Zain-Naqvi-tech/ARM-baremetal-CAN-IDS/README.md

# ARM-BareMetal-CAN-IDS

**A multi-ECU automotive CAN network featuring a custom firmware-level Intrusion Detection System (IDS).**

## Project Overview
This project implements a secure, multi-node automotive controller area network (CAN) entirely on a single ARM Cortex-M4 microcontroller (MSP432E401Y) using bare-metal C. 

By leveraging the dual built-in CAN controllers (CAN0 and CAN1) routed through external physical transceivers, this system creates two independent hardware nodes operating on a shared physical bus:
* **Node 1 (Engine ECU):** Broadcasts realistic automotive telemetry (RPM, throttle, speed, and temperature) at standard vehicular message rates.
* **Node 2 (Body Control Module):** Actively listens, processes, and responds to the network traffic.

## At a Glance

Five anomaly detectors, an on-demand fault-injection framework driven over UART, and a live Python dashboard.

| Detection | What it catches | Method | Verified on hardware |
|---|---|---|---|
| **Over-range** | A signal past its physical limit (RPM > 6000) | Per-frame value check in the RX interrupt | ✅ RPM forced to 6500, flagged every frame |
| **Too-fast** | A message arriving faster than its schedule (replay / injection) | Inter-arrival timing vs. expected period | ✅ Extra throttle frame every 1600 ms, flagged |
| **Missing** | A message that stops arriving (silenced / dropped node) | Deadline watchdog scanned in the main loop | ✅ Speed silenced 2 s, flagged on the deadline, recovers on resume |
| **Unknown ID** | A frame from an ID outside the known network (rogue ECU) | Hardware catch-all message object + match priority | ✅ Rogue 0x500 flagged, known IDs untouched |
| **Spike (rate-of-change)** | A value that stays in range but jumps faster than physically possible (in-range spoofing) | Frame-to-frame delta vs. a per-signal limit | ✅ Coolant forced 30 → 60 C, flagged once on the jump |

**Interactive:** every attack is triggerable live from the host with a single keypress over UART, and the dashboard shows each signal decoded into real units with color-coded status. Detection spans three axes: **value** (is it possible?), **timing** (too fast, or gone?), and **identity** (does this ID belong?), plus a rate-of-change rule for spoofing that stays within legal bounds.

Demos:

[Python Dashboard](https://youtu.be/XWLsz7M9KcM) 

[Realterm Ouput](https://youtu.be/OpzYNLC9uAE)

Full implementation, the debugging stories, and the design decisions behind each detector are in the milestones below. Performance Metrics are included at the end

## Phase 1: Hardware Setup & Bare-Metal Initialization
* **External Hardware:** Utilized SN65HVD230 CAN transceivers for physical communication. The modules include built-in 120Ω termination resistors across the CANH and CANL headers.
* **MCU Configuration:** Located and mapped the specific registers and GPIO pins responsible for CAN communication on the Cortex-M4.
* **Bit Timing:** Researched CAN bit timing architecture and calculated the appropriate Baud Rate Prescaler (BRP) using the standard bit rate formula to establish a stable connection.

Transceiver Used:
WhatsApp Image 2026-05-28 at 00 55 18

### Wiring Setup
The physical bus uses a twisted-pair configuration to resolve electromagnetic interference (EMI) and maintain signal integrity.



WhatsApp Image 2026-05-28 at 00 55 05

**The Physical Bus (Backbone)**
* `CANH` on Transceiver 1 <---> `CANH` on Transceiver 2
* `CANL` on Transceiver 1 <---> `CANL` on Transceiver 2
(These two wires are twisted together between the nodes).

**Node 1 (CAN0 - Engine ECU)**
* `VCC`  -> MCU 3.3V
* `GND`  -> MCU Common GND
* `TXD`  -> MCU Pin PA1 (CAN0TX)
* `RXD`  -> MCU Pin PA0 (CAN0RX)

**Node 2 (CAN1 - Body Control Module)**
* `VCC`  -> MCU 3.3V
* `GND`  -> MCU Common GND
* `TXD`  -> MCU Pin PB1 (CAN1TX)
* `RXD`  -> MCU Pin PB0 (CAN1RX)

## Milestone 1: TX/RX Proof of Life

The first integration milestone: a single CAN frame transmitted from CAN0, received by CAN1 across a physical two-node bus, and parsed out of the receiving message object. No CAN library used

**What this proves**
- Both CAN controllers brought up from raw registers with a bit timing for 500 kbps (BRP=14, TSEG1=12, TSEG2=3) and message-object configuration using the IF1/IF2 indirect interface
- CAN0 transmits a standard 11-bit frame
- CAN1 receives it, and the firmware reads the frame back out of the message object (`WRNRD=0`) and parses ID, DLC, and the 8 payload bytes into a `Msg` struct

**Verified result**: debugger watch window after one TX → RX cycle:

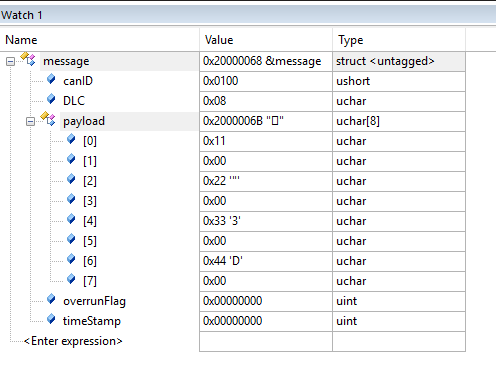
[picture p1: images/image.png]


## Milestone 2: Stream live CAN traffic to a host PC using UART

**Why UART2:** Enabling CAN0 (jumpers JP4/JP5) reassigns PA0/PA1 away from
UART0, so per the board user guide UART2 (PD4/PD5) becomes the XDS-110
backchannel.

**Config:** 115200 8-N-1, PIOSC clock (IBRD 8 / FBRD 44); PD4/PD5 muxed to
UART2 alternate function, Port D clock enabled.

**Trace format** — `Message_Object_UART_Print()` emits fixed CSV
`DIR,ID,DLC,payload…,timestamp`:

```
RX,0x100,8,0x11,0x00,0x22,0x00,0x33,0x00,0x44,0x00,0
```

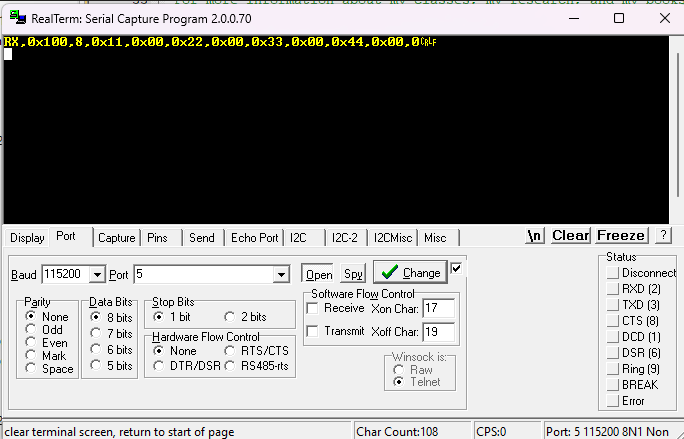
[picture p2: images/image-1.png]
UART2 CAN trace in RealTerm

## Milestone 3: Multi-ECU Bus + Interrupt-Driven Monitor

Implement a realistic multi-ECU CAN bus and monitor it live. Four ECUs broadcasting on independent schedules. The node receiving every frame through interrupts and streaming it to UART on RealTerm

**TX:** Sends four message objects at their own periods -> RPM (0x100, 500ms), throttle (0x200, 1s), speed (0x300, 2s), and coolant (0x400, 4s). Different CANIDs for all

**RX:** CAN1 uses one message object per ID (we can do a total of 32) with receive interrupts enabled. The ISR (CAN1_IRQHandler) identifies the message object using CANINT, drains the pending objects using a loop, and hands it off to main using the flag bitmask. Main prints each frame using UART2 after checking if the specific bit of the flag bitmask is set. After printing, it clears that bit from flag.  

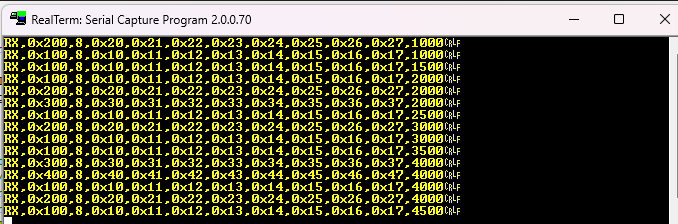
[picture p3: images/image-2.png]
Multi-ECU trace in RealTerm

> Design note: RX is interrupt-driven so the monitor never stalls the TX
> scheduler and never misses a frame; the ISR stays short (capture only),
> with the UART print moved to main (slower than the ISR in general)

## The Intrusion Detection System (IDS)
Running concurrently on the same Cortex-M4 core is a lightweight, custom-built Intrusion Detection System. It actively monitors the raw bus traffic to detect and flag common automotive cybersecurity threats and anomalies, including:
* **Timing Violations:** Detecting messages sent outside their expected timing windows.
* **Unexpected Message IDs:** Flagging unauthorized or unknown device IDs attempting to transmit on the bus.
* **Value Check:** Identifying impossible (or out of range) values for certain properties such as RPM, Vehicle Speed, Throttle, and Coolant Temperature. 

## Test — OVER_RANGE Detection (Value Check)
Every property has been given a maximum value. Anything over this value would be an anomaly. Every message struct has also been given a status which is used for UART printing.  `ENGINE_RPM` is set to 6500 (0x1964 in payload array) which is GREATER than the maximum threshold value of 6000 
The rest have a payload under their maxValue threshold. We expect the RPM status to be 'OVER_RANGE' and the rest to be 'OK'

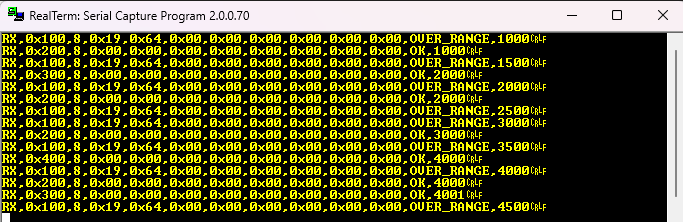
[picture p4: images/image-3.png]
UART output testing message status 

## Test — TOO_FAST Detection (Frame Injection)

The IDS flags a message arriving faster than its defined period

**Setup:** an attacker block injects an extra throttle frame (ID 0x200) every 1600 ms, off the event's normal 1000 ms schedule. The legit throttle ECU keeps its own rhythm untouched.

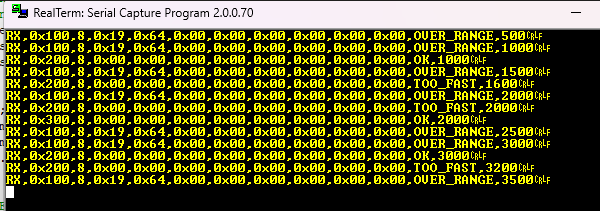
[picture p5: images/image-4.png]
TOO_FAST detection in RealTerm


**Mistakes on the way here:**
- Tried injecting with a blocking delay loop. This only froze the scheduler and shifted every timestamp, because `ticks` runs in hardware regardless of a busy-wait. *Lesson: inject traffic, not delays.*
- First attacker block fired on the loop index and flooded every message. *Lesson: target one specific victim.*

A design choice was made here: To account for jitter such as arbitration delays for lower-priority CAN IDs (it can be seen for 0x400 that it arrives 1ms later than the rest due to the scheduling), the IDS has not been hardcoded to say that a normal send on the right time is OK even though it was only flagged TOO_FAST due to an earlier attacking send which was TOO_FAST itself. 

## Test — MISSING Detection (Silencing an event for a specific time period)

The IDS flags a message that *stops arriving*. A dropped, disconnected, or attacker-silenced node.

**Setup:**  suppress a victim's transmissions for a window. I target
VEHICLE_SPEED (2 s period), silencing it from t=2.5 s to t=4.5 s so it misses its
4 s slot, then recovers.

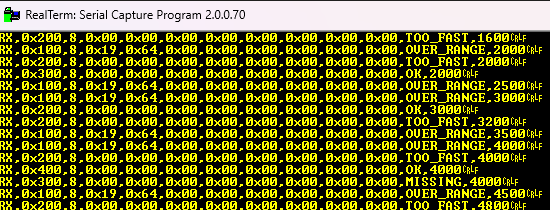
[picture p6: images/image-5.png]
MISSING detection in RealTerm


**How I got here (and what I learned):**
- First tried to fake it with delays and disabled-interrupt tricks, all failed,
  because `ticks` runs in hardware and a busy-wait just freezes the scheduler.
  Realized (same lesson as TOO_FAST) you inject by changing *traffic*, not *time*. We can work
  here by *removing* a transmission rather than adding one.
- Initially buried the logic inside `CAN0_Transmit` with an early
  `return` if the time period was met. It worked but was working on the BUS side in a CAN function. Wanted to move it to main, so had to use abstraction.

SPEED is flagged MISSING exactly once on the edge, stays silent, then re-arms and returns to OK when it resumes at 6 s. Makes the full trip

## Test — Detecting Unknown IDs (Promiscuous)

A frame shows up with an ID that isn't supposed to be on the bus at all is being flagged by the IDS in this case

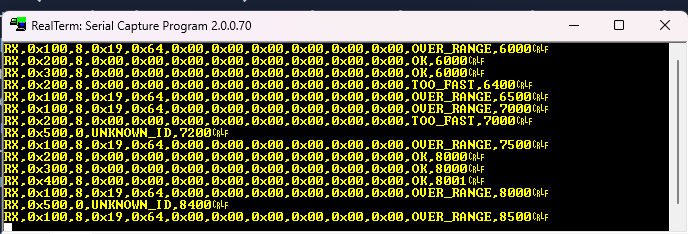
[picture p7: images/image-6.png]
Unknown ID detection in Realterm


My first instinct was to make a clear software flagging system which would go across the array of IDs and see if the incoming ID is allowed or not. Then, I learned about CAN's own acceptance filtering system in the MCU. We originally set every event's ID into the transmit setup function which set everyone up with specific IDs at the start. Anything other than this would not be accepted. However, the mask bits and registers exist for this exact reason. 

I added a new object in the setup and made it 'catch-all'. Its ID mask set entirely to 'don't care' which accepts everything. The ID field was left cleared in the arbitration 2 register to make sure it is not accepting only one specific number. The MCU stores a received frame in the lowest-numbered object that matches. Therefore, the known IDs fall in their own registers and are never flagged. Anything unknown automatically makes it to the next available object that we just put in (object 5). This means that any ID in that object is unknown and therefore invalid. 

The ISR is responsible for checking and declaring any status changes to the event. The ISR checks in the NEW object (5) and if something exists there, it means it has an invalid ID and therefore needs to be flagged to UNKNOWN_ID

**A bug I faced for a while.** My first iteration of this implementation flooded the entire bus with constant UNKNOWN_ID and MISSING lines. Every ID read 0x0. This was because of the way I handled the message array and its size after adding another object. I changed the preprocessor constant NUMBER_OF_EVENTS to 5 to match the new number of objects. However, this also meant that the loops running in main, CAN0/CAN1 Receive_Setup/Transmit_Setup, were all going one extra iteration. That pulled the uninitialised object 5 into the scheduler which always ran because ticks - lastTransmitted >= period now meant ticks - 0 >= 0. The fix was to keep the constant same, BUT increase the size of the message array by 1 -> `message[NUMBER_OF_EVENTS + 1]`. The new object does not need to go through the for loop which targets the main 4 objects.

**Testing it:** Created a new functin called `INJECT_UNKNOWN_ID` which takes in the message, a timer, and an index. The index would be the `new object number - 1` -> `5 - 1 = 4`. This function sends a message with the message ID 0x500 on the bus using ticks and the attacker timer from main. It sends the message every 1200ms. If known IDs were leaking into this catch-all, they would also be flagged, which is not the case right. 

## Traffic Visualization
The firmware is interfacing with a custom Python dashboard that visualizes the live bus traffic over a serial connection. It will log standard telemetry while instantly flagging network anomalies and spoofing attempts in real time.

Up to this point the UART link was one-way. To make the IDS demoable from a user's perspective, I made it bidirectional. The host can send a single character, the firmware injects the matching attack, and the detector lights up in real-time

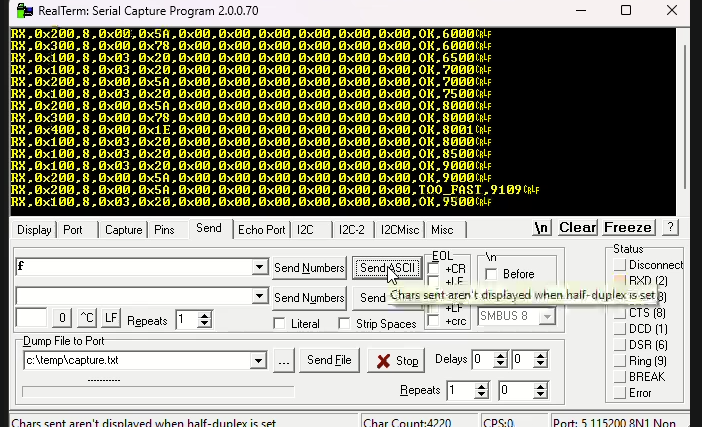
[picture p8: images/image-7.png]
Interactive injection on the live dashboard


The initial trap with reading UART characters in the main loop is the blocking nature of the UART_Inchar function. It uses a while loop to keep checking the UART Flag `UART_FR_R` register. While it waits, the CAN system freezes. Therefore, a rather different system was implemented. Check the flag only once per function call, and set a software flag which we set if there is data waiting in the buffer. Then, return that char from the UART RX input. The main function looks for the flag and its value on every run, and when it is set to 1, it chooses between a set of characters using a switch case statement. Based on the character, specific attacker functions are called

My first injectors were time-based and ran every few ms. However, this new feature allows the user (attacker) to send in attacks at any time. The three are not the same kind of events, so one-shot means something different for each:
- `f` (too fast): transmit one off-schedule throttle frame
- `o` (over-range): force the RPM value high which persists as a stuck value until a manual reset. 
- `u` (unknown ID): sends one rogue data frame with an ID outside of the allowed IDs (0x500). shows up as an unknown ID everytime we send it in

**Result:** From the host machine (laptop's Realterm) we can trigger any attack and watch the matching data flip status live. The normal traffic is not affected. Result can be seen in the image above. ps. video demos on Notion. 

The python dashboard has been added to keep the latest result in front of us for better live observations. Result can be seen in the image below

Python Dashboard with Live changes

## Test — SPIKE Detection (Rate-of-Change)

This is the detector I designed after spotting a gap in the other four. OVER_RANGE catches a value that crosses its ceiling, but it says nothing about a value that stays inside the legal range and simply jumps to an impossible degree. An attacker spoofing a believable value, even if it is wrong will result in a reading that looks legal.

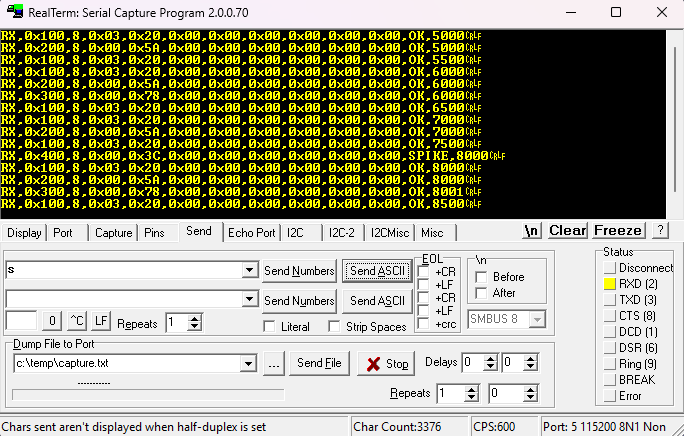
[picture p9: images/image-9.png]
SPIKE detection in RealTerm


**The idea.** A real physical signal can only change so fast. An engine can't gain 4000 RPM in half a second, and coolant physically cannot jump 30°C in one 4-second frame. So instead of checking a value against a ceiling, I check the *delta between consecutive frames* against limit. Each message keeps a `lastValue` and a `maxMargin`; when a new frame arrives, if the jump from the last value exceeds the margin, it's status is flagged as SPIKE.

A spoofed value can be both out of range and a huge jump. I decided OVER_RANGE wins that tie. It is more specific, so the spike check only fires when the frame isn't already flagged over-range.

**Testing:** `INJECT_SPIKE` forces COOLANT_TEMP from its original 30°C to 60°C which is a 30-degree step that's thermally impossible in one frame, but still far below the 120°C ceiling, so only the rate check can catch it. On the next coolant frame it's flagged SPIKE once on the jump, then settles to OK at the new level. The spike is the transition, not the new value. The other signals and the over-range path stay untouched.

# Performance Metrics

## Performance — Detection Latency

**Measurement:** Time from a frame being captured in the ISR `CAN1_IRQHandler` to the moment the IDS makes a final decision on the status of the message. Initially, the goal was to find the time from the moment a fault is injected. However, that time would be from transmission all the way until the status change which would also require travelling time from the wires. To avoid that delay AND make sure that we are measuring the time of the IDS itself, it was decided to take the time between the receival and status update. So, the time will be measured at EVERY loop of receivals and updates.

**What I used:** The Cortex-M4 has an internal counter known as DWT Cycle Counter `CYCCNT`. It runs at system clock speed (120MHz) -> 8.33ns per tick. Enabled purely in software and did not require any trace units (The CMSIS-DAP debugger can not stream trace). This was chosen over the SysTick counter, for a 1ms delay between checks would be too granular. It would be blind to microsecond updates.

Using this counter, to find the current time, one must execute the command `Time = DWT->CYCCNT;`

`StartTime` is latched in the ISR as each frame is read out of its message object. `StartTime` has been added as a message object struct element. This makes sure that each message has its own starting time to avoid any conflicts or overlaps. 
`StopTime` is latched in two places. Firstly, in the ISR. Here, it is found right after interrupt flag is set which essentially sends the object to main. This focuses on both the OVER_RANGE and UNKNOWN_ID branch. Secondly, in main right before the main uart print for the message object. This focuses on the SPIKE and TOO_FAST branches

**Results:** 

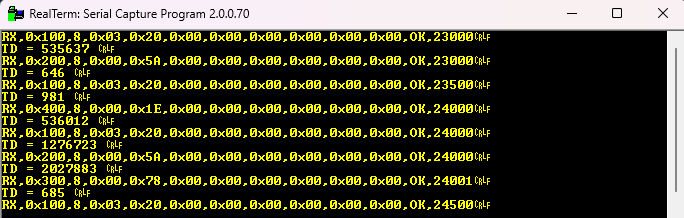
[picture p10: images/image-10.png]


| Condition | Latency (cycles) | Latency |
|---|---|---|
| Uncontended (frame arrives alone) | ~460–860 | ~3.8–7.2 µs |
| Contended (frames share a tick) | ~1.14 M  | ~9.5 ms |

**Results Explained:** A frame that arrives while the main loop is idle (a frame that arrives alone) is classified almost immediately. The few microseconds are due to the ISR capture work and the jump to main. When multiple ECUs coincide on one tick (e.g. RPM, speed, and throttle all at the same time), the system is designed to work like a pipeline. The ISR captures them back-to-back, then main processes them serially, and each message is followed by a uart print. Later frames in the burst of frames wait behind the prints of the earlier ones, so their verdict times go up to milliseconds. They are all received and decoded in the while loop of the ISR back to back. This whole pipeline of multiple ECUs is significantly more time-consuming than a single frame. 

**Takeaways:** This is the quantitative proof of the IDS detection and classification system. The detection itself is in microseconds, and the millisecond tail is the cost of handling multiple frames. Something I realized from this is the observer effect. By putting out these timers and uart print statements for latency, I am essentially increasing the latency. 

## Performance — ISR Execution Time

**Measurement:** Duration of the CAN1 receive interrupt handler. It fills up `StartTime` at the start of the function before anything happens. It fills up `StopTime` before the return statement and after the while loop ends. This shows us how long the core spends in the `CAN1_IRQHandler` per invocation. While the interrupt runs, everything else is paused so now we know how much time this costs us. 

**What I used:** Same DWT Cycle Counter as before

After the time difference is calculated inside the ISR, it is compared with a variable `maxISRCycles`. If the current delta is bigger than the max, set the max to the current delta. This is then sent on to main for printing. 

**Results:**

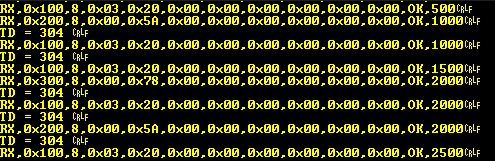
[picture p11: images/image-11.png]


| Measure | Cycles | Time |
|---|---|---|
| Typical (single object) | ~304 | ~2.53 µs |
| Measured max (single object, bus load) | ~340 | ~2.83 µs |

From 304, it goes to 336 for a bit, then becomes stable at 340. The small difference here could be due to the `BUSY` poll on the IF2 transfer. 

The drain loop never engages. The handler is built to drain all pending messages in a loop. So, the worst case with N objects in one invocation never happens. 2 or more objects dont invocate the IRQ at the same time which I assumed it would. The ISR always runs for that ONE call. A frame at 500kbps takes the bus for about 250us. The handler runs in approx. 2.5us. So, the frames are 100x further apart than the handler. By the time the second frame finished arriving, the first one's ISR is long done. Every interrupt processes exactly one object. What I expected here for worst case was 4 message objects x 340 cycles per ISR = 11us. This is never observed. 

**Takeaways:** The ISR stays short by design. Captures the frame, sets a flag, leaves. A 2.83us worst case against the fastest message period (RPM, 500ms) is a decent ISR runtime. This matters for a real-time argument

## Performance — CPU Headroom

**Measurement:** We are looking for the CPU headroom. In order to find this, we must find the utilization of the CPU for the main part of the program. This means from the moment that the interrupt flag is checked for a new message object until after the message has been printed, is our time per message. Utilization is the time taken per message divided by its period. Headroom is the slack (1 - utilization). It is how much more the system can absorb before it stops keeping up.

**What I used:** The same DWT counter was used. The main method for figuring out the headroom is sum-of-work. For a periodic system, utilization is the sum of the cost/period of each recurring task. The StopTime is after the message print, for we need to account for the uart print in the cpu time. 

**Results:** 

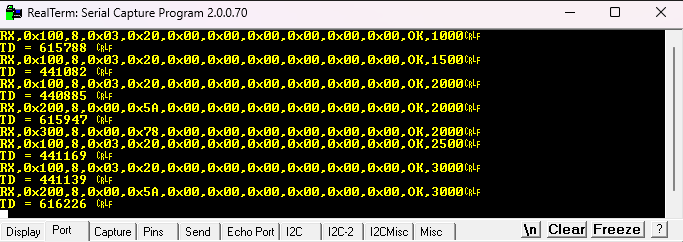
[picture p12: images/image-12.png]


Using these readings, we can find the maximum CPU time this main pipeline takes. Max=616226 cycles. This comes out to be approximately 5.13ms. Min=440885 cycles which comes out to be approximately 3.67ms.

| Component | Cost per frame |
|---|---|
| ISR (capture) | ~2.83 µs |
| Main-side (detect + print) | ~3.67–5.13 ms |

Per frame, the main side is roughly **1800 x ISR**. This entire cost is the UART print. We are going to use the maximum value to find the CPU utilization for the super-loop

RPM = 5.13 / 500 = 1.026%
Throttle = 5.13 / 1000 = 0.513%
Vehicle Speed = 5.13 / 2000 = 0.2565%
Coolant Temperature = 5.13 / 4000 = 0.12825%

Total Utilization = 1.92%
Total Headroom = 1 - Total Utilization = 98.08%

So, approximately 2 percent utilization and 98% headroom which is a consiberably good amount of headroom. It can be increased by turning the UART into interrupt-driven, or lowering the amount of chars it has to output. The UART busy wait is a main eater of the CPU time

**Why the time has a min and max value:** When a print starts against a drained FIFO buffer, the first 16 bytes are dumped into the hardware buffer in a few nanoseconds, bypassing that busy while loop. This results in the 3.67ms time frame. For the other case, the FIFO would already be saturated from the previous message. The CPU hits the while loop on the very first character and must wait for the hardware. This results in an increased time gap. Therefore, we get the larger 5.13ms value. This is pretty interesting to note, as UART is not just a simple print, but rather also eats up some CPU time which COULD be used elsewhere. 

## Performance — False-Positive Behavior

**Measurement:** How often the IDS alarms on false positives. This isolates frames wrongly flagged as attacks. False Positive Rate is FP / (FP + TN) where TN is True Negative. This number must be zero for the IDS to carry weight. This is important, for a wrongly flagged message object can cause devastating failures in the real-world systems and potentially cause unnecessary damages. 

**Method:** Constant-valued traffic would not be able to tell us the reliability of the system. The attacks were changed to implement edge cases and changing values

SPIKE: Value oscillated up and down within the per-signal margin. The downward leg is critical -> The subtraction between the values would return a negative number and we need to deal with it. Initially, I conducted the subtraction using unsigned integers which would wrap the number around to a very big value and ruin the results. However, with the change of making them signed, and adding an ABS pre-processor function to use on the subtraction, I was hopeful it would work. Stayed OK in both directions, so our False Positive Rate is 0

OVER_RANGE: Value held one count BELOW the limit (5999 against a 6000 limit). Stays OK. This was more of an edge case test. The collision between SPIKE and OVER_RANGE was conducted in the same run. The value, initially at 800, was raised to 5999 (which raised SPIKE as expected) then 6500 which would raise BOTH spike and OVER_RANGE. But because OVER_RANGE has precedence, it was chosen. Then, it oscillated between the two. False positive rate is 0

TOO_FAST: Never fires under scheduled arrival. Only a deliberate early frame triggers it. 

MISSING/UNKNOWN_ID: On-time arrivals and known IDs are never flagged

**Results:**
| Detector | Benign stress applied | False positives |
|---|---|---|
| SPIKE | up/down oscillation within margin | 0 |
| OVER_RANGE | value held one count below the limit | 0 |
| TOO_FAST | scheduled (non-early) arrival | 0 |
| MISSING | on-time arrival | 0 |
| UNKNOWN_ID | known IDs only | 0 |

False Positive rate is 0 percent across all detectors under benign and boundary traffic.

## Bus-Off Recovery (Scoped out)

**What it is:** CAN nodes have a Transmit error counter (TEC) and a receive error counter (REC). I used them for my initial testing phase during the bare-metal setup of the nodes. I also learned that the TEC gets pushed up for each failed transmission. Once the TEC goes past 255, it is Bus-Off. A node that keeps failing to transmit takes itself completely off the network so it does not bring all of it down. In Bus-Off, the node neither transmits nor receives. 

**How it would be handled if implemented:** The CAN controller enters bus-off automatically when the TEC overflows. It sets the INIT bit in the CAN Control Register (CANCTL), stopping all activities. Once INIT has been cleared, the device then waits for 129 occurrences of bus idle (129 * 11 consecutive high bits) before resuming normal operations. At the end of the bus-off recovery sequence, the Error Management Counters are reset. The CANSTS register has information on the Bus-Off as well, where it raises the BOFF flag so that software can observe the condition. Recovery is not automatic. It remains in Bus-Off until the INIT bit is cleared.
