Zain-Naqvi-tech/ARM-baremetal-CAN-IDS/Drivers/uart.h

#ifndef UART_H
#define UART_H

#include <stdint.h>
#include "can.h"

void UART_Init(void);

// Wait for new input, then return ASCII code 
char UART_InChar(void);
// Wait for buffer to be not full, then output 
void UART_OutChar(char data);
void UART_printf(const char* array);
void Status_Check(char* array, int status);
void UART_numeric_print(uint32_t num);

volatile extern uint32_t RXFlag;

void Message_Object_UART_Print(uint32_t direction, volatile Msg* message);

#endif
