Zain-Naqvi-tech/ARM-baremetal-CAN-IDS/Drivers/can.h

#ifndef CAN_H
#define CAN_H

#include <stdint.h>

#define NUMBER_OF_EVENTS 4
#define TX_MSG_OBJ 1
#define RX_MSG_OBJ 1
#define DA1 0x11
#define DA2 0x22
#define DB1 0x33
#define DB2 0x44

typedef enum {
	OK,
	MISSING, //also acts as too slow 
	TOO_FAST,
	OVER_RANGE,
	UNKNOWN_ID,
	SPIKE
} ERROR_STATUS;

typedef struct {
	uint16_t canID; //Event specific ID
  uint8_t DLC; //Data Length Code
  uint8_t payload[8]; //Actual Data the event is sending
  uint32_t overrunFlag;
  uint32_t timeStamp; //Number of ticks that have taken place since the system started working
	uint32_t lastTransmitted; //This is the last time the message for this event was transmitted
	uint32_t period; //This is the time it takes for this particular event to send a message
	ERROR_STATUS status; //This indicates the error status
	uint16_t maxValue;
	uint32_t lastArrived; //This is the last time the message for this event was received - used to determine if a message is missing or not
	uint32_t valueMargin; //This is a margin 
	uint32_t arrivalFlag; //This flag is checked before timing checks. If the flag is zero, it means that this was the first arrival and the too fast/too slow does not matter
	uint32_t lastValue; //This is used to track the last transmission value and use it to compare with the current frame to check for spikes
	uint32_t maxMargin; //This is the maximum difference between the current and last transmission value. It is used to see if the difference is big enough to declare it a spike
} Msg;

typedef enum {
	ENGINE_RPM,
	THROTTLE,
	VEHICLE_SPEED,
	COOLANT_TEMP
} PROPERTY;

volatile extern Msg message[NUMBER_OF_EVENTS + 1];
volatile extern uint32_t InterruptFlag; //This will be used as a bitmask -> 0x00000000 (8*4=32)

void CAN0_Init(void);
void CAN1_Init(void);

void CAN0_Transmit(volatile Msg* message, uint32_t index);

void CAN_Message_Table_Init(volatile Msg* msg);

void CAN0_TX_Setup(volatile Msg* msg);
void CAN1_RX_Setup(volatile Msg* msg);

#endif
