Zain-Naqvi-tech/ARM-baremetal-CAN-IDS/(commit log)

2026-05-29 initialise CAN0/CAN1 hardware routing and GPIO registers - Create and setup can.c/can.h - Configure Port A (CAN0) and Port B (CAN1) peripherals - Implement AFSEl -> PCTL -> DEN sequence to prevent ph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
    [can.c, can.h, gpio.c]
2026-05-31 add CAN0 transmit and CAN1 receive logic - Configure IF1 (interface 1) registers for CAN0 to transmit an 8-byte test payload - Configure IF2 registers for CAN1 to filter and receive CAN ID 0x100
2026-06-02 add a function which reads out all the data from the Receiving CAN node - conduct loopback testing to confirm TX works - added some error and debugging LED functions
    [can.c, can.h, gpio.c, gpio.h, main.c, throw_error.c]
2026-06-03 feat(uart): add UART channel and parseable CAN message object object Bring up UART2 as the XDS-110 backchannel debug UART at 115200 8-N-1. Required because the JP4/JP5 CAN jumper configuration reassi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
    - Configure UART2 from PIOSC (16 MHz): IBRD=8, FBRD=44 for 115200 baud
    - Mux PD4 (U2Rx) / PD5 (U2Tx) to alt-function 1 via PCTL/AFSEL/DEN
2026-06-07 feat(can): interrupt-driven multi-object CAN RX with live UART trace Replace the blocking single-object RX poll with an interrupt-driven receive path, so the monitor captures every frame on the bus w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
    - CAN1_RX_Setup: configure one message object per ID - RXIE enabled - enable interrupts (CANCTL IE) and the CAN1 NVIC IRQ
    - CAN1_IRQHandler: identify the source object using the CANINT. unpack the frames into the shared message table
    - ISR: main handoff via a volatile bitmask (one bit per object) so main knows exactly which frames are which
    - main: print received frames using the flag bitmask. clear each bit as it is handled
    Verified on a 4-ECU bus: CANIDs 0x100/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
    [can.c, can.h, main.c, uart.c, uart.h]
2026-06-08 feat(can): add an anomaly detecting system to the CAN Bus. - create a status ENUM which tracks the message status for printing - add a switch-case statement for UART traces - add a maximum threshold 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
2026-06-09 feat(can): add a timing security feature which highlights messages which were too fast or missing entirely - add an arrival flag which helps in receiving the messages for the first time without error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
    [can.c, can.h, main.c, uart.c]
2026-06-10 feat(can): add an attacker system in the main.c file. - the attacker is responsible for sending in a frame BEFORE the expected time. - it tests the TOO_FAST status flagging system of the IDS - checks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
    [can.c, main.c]
2026-06-11 feat(ids): MISSING detection with gated fault-injection Add the node-silencing attack and refactor all fault injections using abstraction into a proper attacker layer, seperated from the CAN setup.
    - attacker.c/h: INJECT_OVER_RANGE, INJECT_TOO_FAST, INJECT_MISSING pulled out of main and the driver into named functions
    - INJECT_MESSAGE is a function that checks if the event is suppressed or not. Gates the transmit call in main to ensure something being suppressed is not transmitted.
    Verified: VEHICLE_SPEED silenced over a 2.5s to 4.5s window is flagged MISSING once on the deadline edge, then recovers to OK on resume.
    [attacker.c, attacker.h, can.c, main.c]
2026-06-12 feat(ids): unknown-ID detection using mask registers and bits
    Detect frames whose ID matches none of the known messages. Used masked catch-all receive object instead of pure software side work
    - CAN1 object 5: masked RX object that accepts any ID. Objects 1-4 take the known IDs first, so anything landing in this new catch-all object is therefore unknown.
    - ISR branches on the new object number and sets the status to UNKNOWN_ID.
    - main handles this outside the main for loop. It checks if the new object is flagged. If it is, then print and clear the interrupt flag
    Verified: known traffic (0x100-0x400) flows to its own objects. Only the injected (0x500) is tripped, confirming the IDS works on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
2026-06-14 feat(ids): interactive fault injection over UART command channel
    Turn the one-way UART trace into a bidirectional link. The firmware now receives single-character commands and triggers attacks on demand, so the IDS can be exercised live from the host with no separate terminal.
    - UART2 RX: Non-blocking poll of the receive FIFO buffer in the main loop. UART_InChar reads only when a byte is present, so it never stalls the CAN scheduler system
    - Refactor the injectors to 'one-shot, user-based'. One keypress maps to one fault injection and observable detection.
    'f' TOO_FAST
    'o': OVER_RANGE
    'u': UNKNOWN_ID
    - Give the simulated signals realistic resting values.
    Verified: f/o/u sent from the hos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
    [attacker.c, attacker.h, can.c, dashboard.py, main.c, uart.c, uart.h]
2026-06-14 feat(ids): rate-of-change (SPIKE) detection
    Add a fifth detector that catches values which stay within their legal range but jump faster than physically possible between consecutive frames.
    - Add lastValue + maxMargin fields for all message events. Compare |value - lastValue| against maxMargin and flag SPIKE on a physically impossible jump
    - OVER_RANGE takes precedence, so a value that is both out of range and has an impossible spike, will be reported as over_range.
    - INJECT_SPIKE function added which forces COOLANT_TEMP (can be any event, takes in an index) to change its value by a margin BIGGER than the allowed one. Changes to 60 degrees. This is physically impossible for a 4 second margi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
2026-06-16 test DWT functionality on the MSP432 MCU.
    - Set the TRCENA bit in the DEMCR register to enable the overall block which DWT uses
    - Set the CYCCNTENA bit in the DWT->CTRL register to enable the counter
    - For the test, extract the counter time from DWT->CYCCNT using two back-to-back reads.
    - Find the difference between the two times, and print using the newly added UART_numeric_print() function
    Verified: UART output shows 4 at the start. This means that the move from one line to the next took 4 cycles which is approximately 33ns.
2026-06-16 feat(ids): add the complete DWT timing mechanism to find detection latency in the IDS.
    - Latch StartTime to the message object struct and fill it once a message is received and enters the ISR
    - StopTime is measured in two different places. Firstly, in the ISR where it accounts for either OVER_RANGE or UNKNOWN_ID and filled right after the interrupt flag's object bit is set. Secondly, in main right before the main message print which accounts for either TOO_FAST or SPIKE
    - Fix the TimeDifference subtraction by using casting on the subtraction to make sure negative numbers do not roll over
    Verified Result: Latency for a singular frame per time: ~4-7 us. Latency for clustered arrivals: ~9.5ms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
    [can.c, can.h, main.c]
2026-06-17 test(ids): test the ISR execution time using the onboard DWT counter >> >> - Set StartTime at the start of the ISR and set StopTime at the end of the ISR right before the return. >> - Find the maximu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
2026-06-17 test(ids): add CPU headroom measurement via sum-of-work utilization
    Measure main side per-frame processing cost for the CPU. Used a DWT cycle counter to compute utilization (U = sum(Ci / Ti)) across the 4 messages
    - Stop after the final message uart print statement. Start recording the time as soon as the interrupt flag brings in a specific message object.
    - Move the start,stop, and time difference variables to the main.c file as a local scope only. Not sharing with the can modules anymore
    Result: Approximately 2 percent CPU Utilization. Therefore, a 98 percent CPU Headroom. The load is entirely the UART spin wait.
2026-06-18 test(ids): conduct tests for false-positive rates of the IDS
    - Update frame injection functions to test edge cases and test for false positive rates.
    Verified: They have all retured 0 percent false positive rates. This further credits the IDS
